royalcow/proton-pack/(list of files, cad)

Other CAD files:
stls/PKE Meter/front_top_repaired.stl
