royalcow/proton-pack/TODO.md

# Proton Pack TODO

> **Deprecated:** Active project work is now tracked with GitHub Issues.

## Active work

See the repository issue tracker:

https://github.com/royalcow/proton-pack/issues

Do not add new tasks to this file. Create or update a GitHub Issue instead.

## Project documentation

- `PROJECT.md` — current project state and architecture
- `DECISIONS.md` — architectural decisions
- `PINOUTS.md` — as-built wiring and hardware verification
- GitHub Issues — planned and active work
- `CHANGELOG.md` — project changes

This file is retained temporarily as a stable entry point for existing references and tooling and may be removed once those references have migrated to GitHub Issues.
