royalcow/proton-pack/(commit log)

2026-09-19 Initialize BOM.md
2026-09-19 Verify D2 power-cell and D3 cyclotron data pins
2026-09-19 Mark battery voltage check as firmware-only
2026-09-19 Track 3D model assets and ignore slicer output
2026-09-19 Add PKE Meter STL source tracking
2026-09-19 Update ESP32 controller planning in BOM.md
2026-09-19 Update ESP32 controller planning in DECISIONS.md
2026-09-19 Update ESP32 controller planning in PROJECTS.md
2026-09-19 Update ESP32 controller planning in PINOUTS.md
2026-09-19 Document ESP32-S3 controller migration architecture
